sijeffrey/Supervisory/hardware/BOT.png

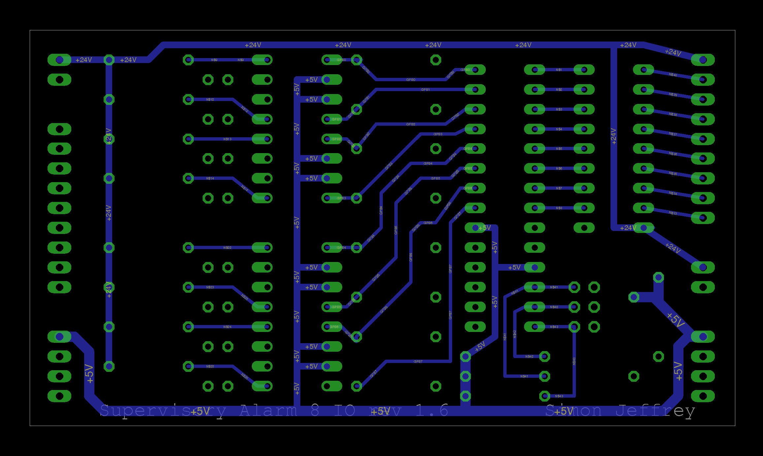
hardware/BOT.png
