sijeffrey/Supervisory/hardware/SILK.png

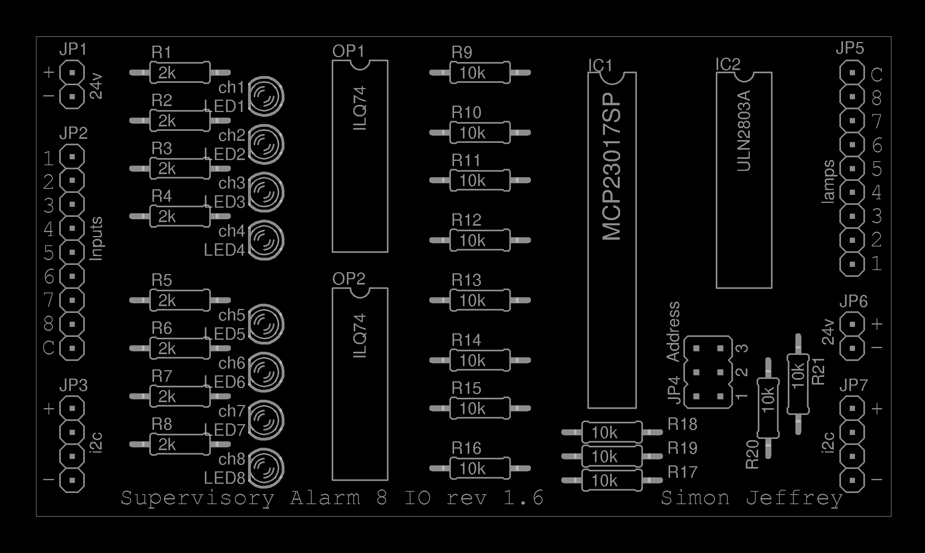
hardware/SILK.png
