sijeffrey/Supervisory/hardware/TOP.png

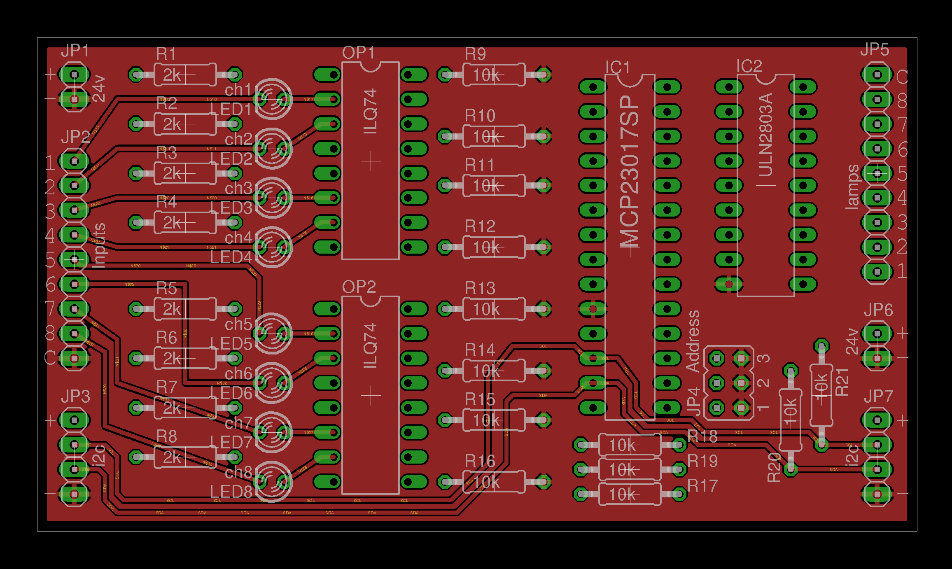
hardware/TOP.png
