sijeffrey/Supervisory/hardware/8 IO v1-6.pdf

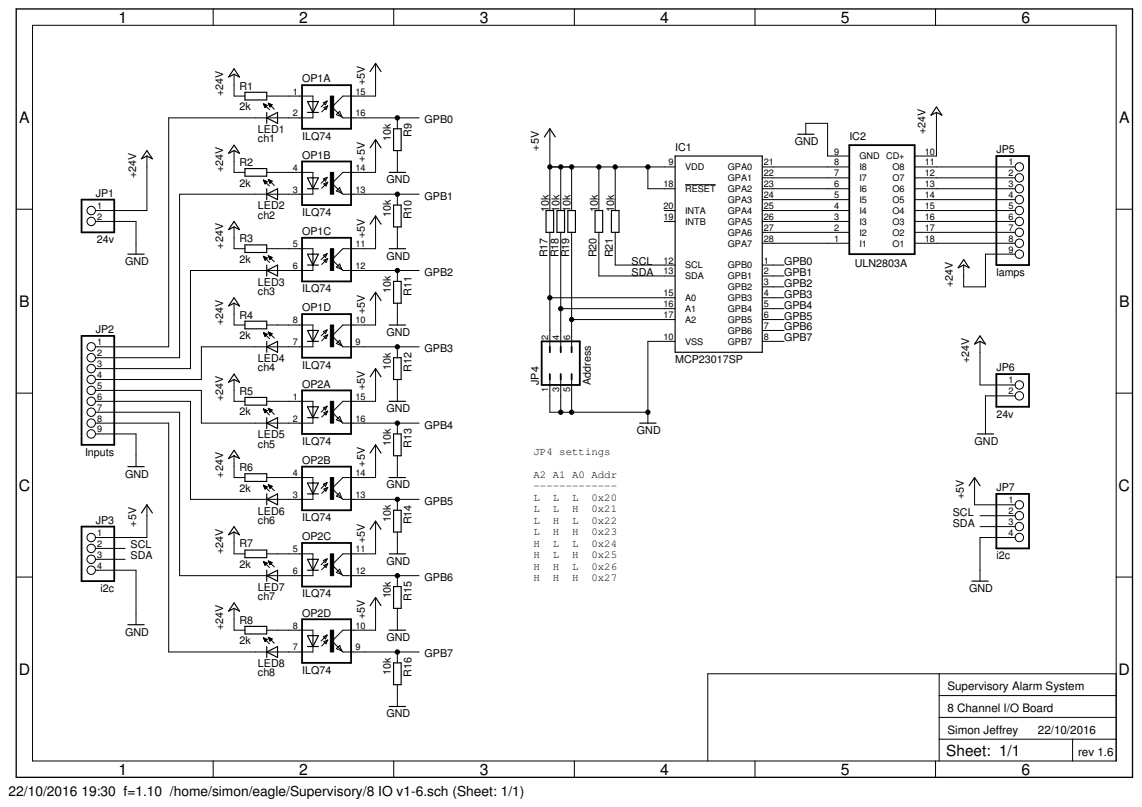
[picture p5: page 1]

16
17

22/10/2016 19:30 f=1.10 /home/simon/eagle/Supervisory/8 IO v1-6.sch (Sheet: 1/1)
