sijeffrey/Supervisory/(commit log)

2016-10-22 update to include i2c and 24v link through
2016-10-22 added pull up resistors to i2c lines
2016-10-22 PCB design and schematic uploaded
